Galacs/s6tm-detect-cb-2/s6tm-detect-cb-2.kicad_pcb

## KiCad design s6tm-detect-cb-2.kicad_pcb (2026-09-27)

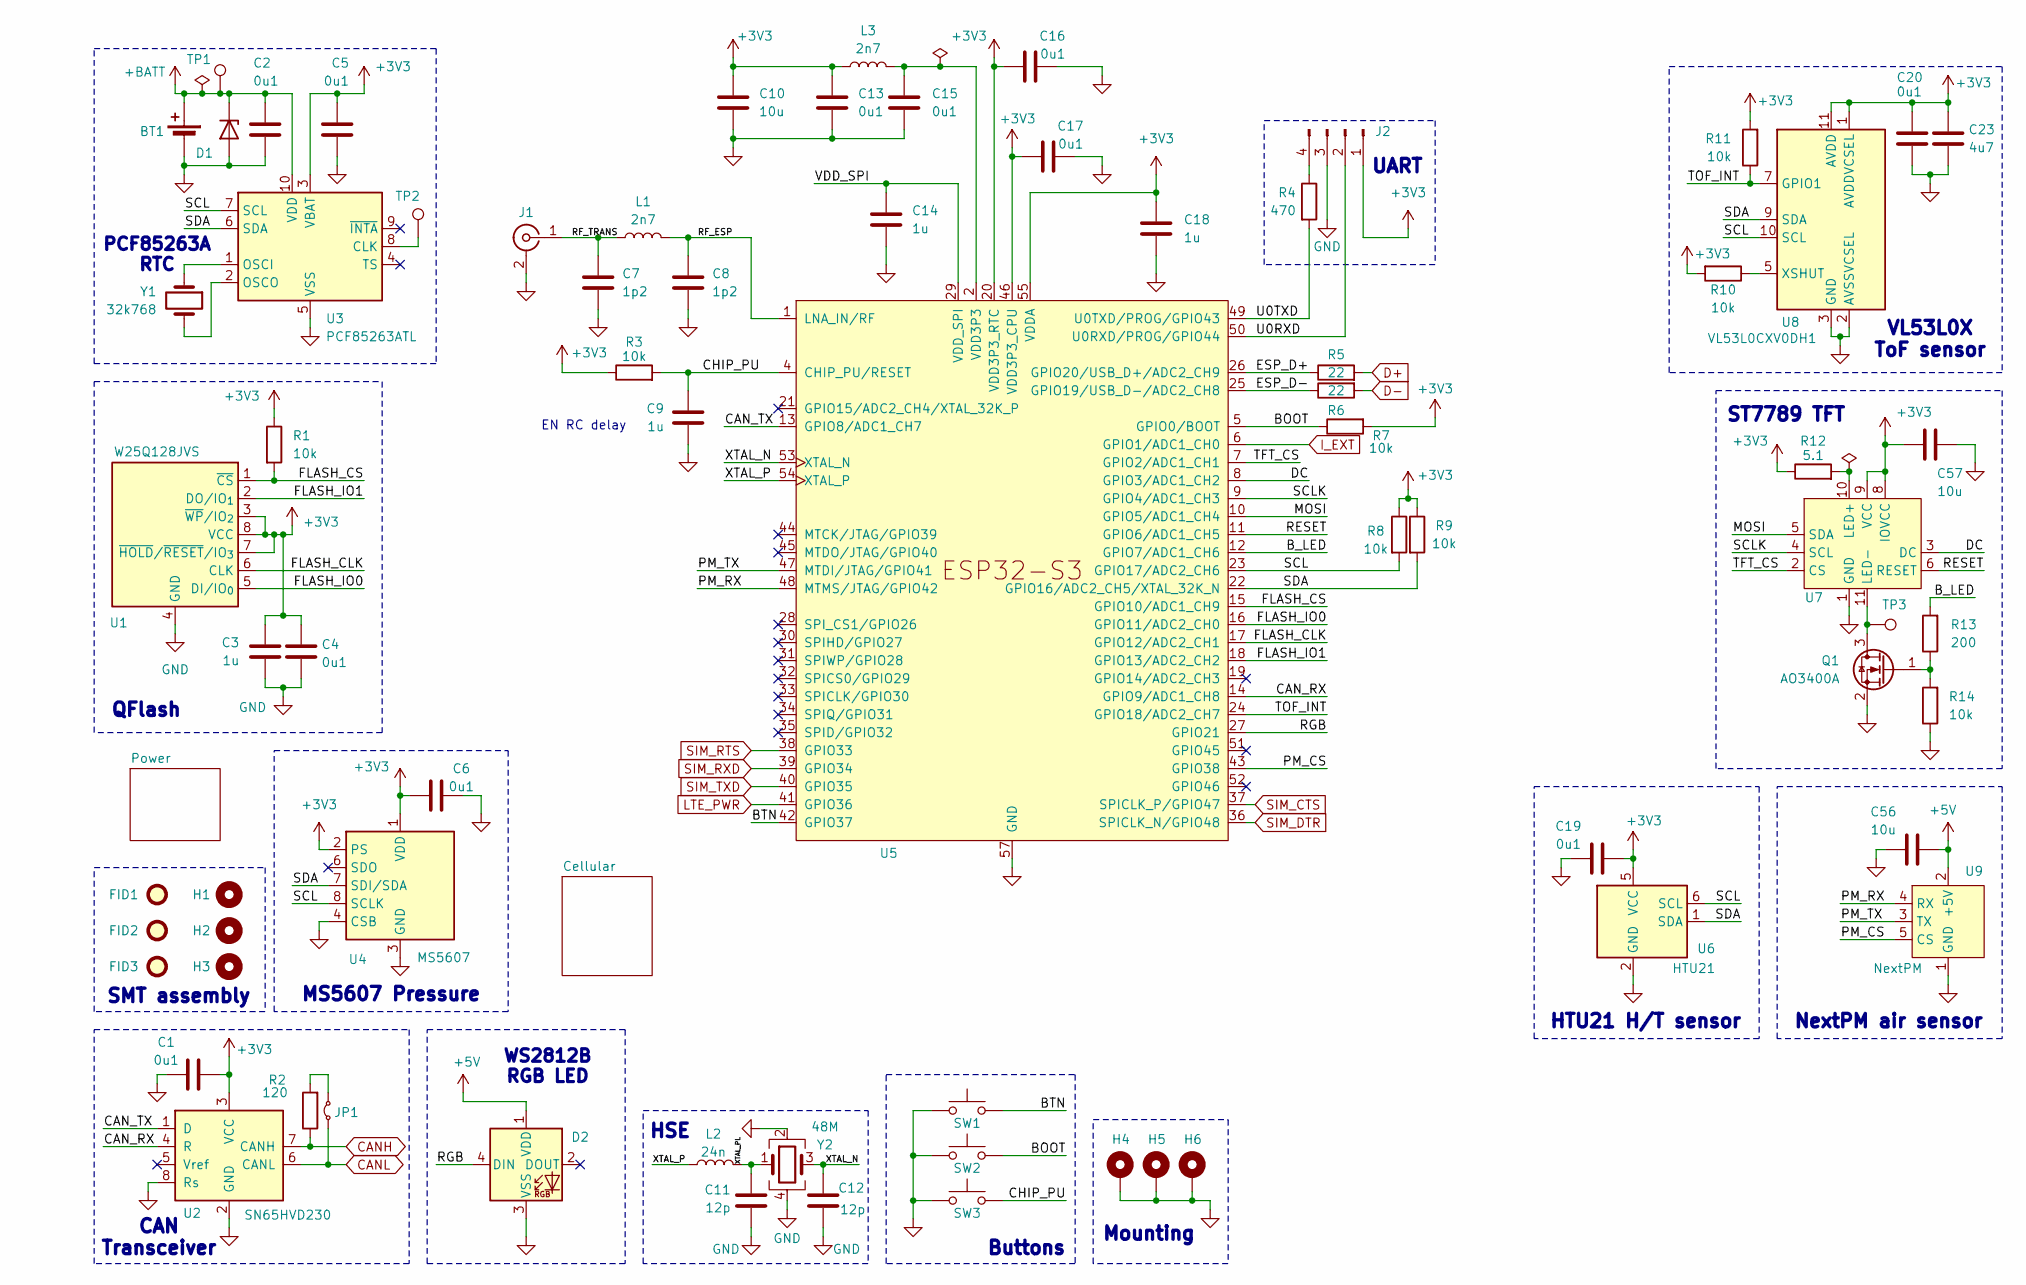
[picture p1: schematic s6tm-detect-cb-2.kicad_sch, S6TM Detect Carrier 2]

Parts:
BT1: Battery_Cell; BatteryHolder_MYOUNG_BS-08-B2AA016; Manufacturer Part Number BS-08-B2AA016; JLCPCB Part # C964792
C1, C2, C4, C5, C6, C13, C15, C16, C17, C19, C20: 0u1; C_0402_1005Metric; Manufacturer Part Number CL05B104KB54PNC; JLCPCB Part # C307331
C3, C9, C14, C18: 1u; C_0402_1005Metric; Manufacturer Part Number CL05A105KA5NQNC; JLCPCB Part # C52923
C7, C8: 1p2; C_0402_1005Metric; Manufacturer Part Number GJM1555C1H1R2WB01D; JLCPCB Part # C76899
C10, C56, C57: 10u; C_0603_1608Metric; Manufacturer Part Number CL10A106KP8NNNC; JLCPCB Part # C19702
C11, C12: 12p; C_0402_1005Metric; Manufacturer Part Number 0402CG120J500NT; JLCPCB Part # C1547
C23: 4u7; C_0402_1005Metric; Manufacturer Part Number CL05A475MP5NRNC; JLCPCB Part # C23733
D1: H5VU10U; Diode_DFN1006; Manufacturer Part Number H5VU10U; JLCPCB Part # C22395519
D2: WS2812B; LED_WS2812B_PLCC4_5.0x5.0mm_P3.2mm; Manufacturer Part Number WS2812B-V5/W; JLCPCB Part # C2874885
FID1, FID2, FID3: Fiducial; Fiducial_1mm_Mask2mm
H1, H2, H3: MountingHole; ToolingHole_1.152mm
H4, H5, H6: MountingHole_Pad; MountingHole_3.2mm_M3_Pad_Via
J1: Conn_Coaxial; U.FL_Hirose_U.FL-R-SMT-1_Vertical; Manufacturer Part Number U.FL-R-SMT-1(80); JLCPCB Part # C88374
J2: Conn_01x04_Pin; PinHeader_1x04_P2.54mm_Vertical
JP1: Jumper_2_Small_Bridged; SolderJumper-2_P1.3mm_Open_RoundedPad1.0x1.5mm
L1, L3: 2n7; L_0402_1005Metric; Manufacturer Part Number LQG15HS2N7S02D; JLCPCB Part # C77108
L2: 24n; L_0402_1005Metric; Manufacturer Part Number LQW15AN24NG00D; JLCPCB Part # C167472
Q1: AO3400A; SOT-23; Manufacturer Part Number AO3400A; JLCPCB Part # C20917
R1, R3, R7, R8, R9, R10, R11, R14: 10k; R_0402_1005Metric; Manufacturer Part Number 0402WGF1002TCE; JLCPCB Part # C25744
R2: 120; R_1206_3216Metric; Manufacturer Part Number 1206W4F1200T5E; JLCPCB Part # C17909
R4: 470; R_0402_1005Metric; Manufacturer Part Number 0402WGF4700TCE; JLCPCB Part # C25117
R5, R6: 22; R_0402_1005Metric; Manufacturer Part Number 0402WGF220JTCE; JLCPCB Part # C25092
R12: 5.1; R_0603_1608Metric; Manufacturer Part Number 0603WAF510KT5E; JLCPCB Part # C25197
R13: 200; R_0603_1608Metric; Manufacturer Part Number 0603WAF2000T5E; JLCPCB Part # C8218
SW1, SW2, SW3: SW_Push; SW_SPST_TS-1088-xR020; Manufacturer Part Number TS-1088-AR02016; JLCPCB Part # C720477
TP1, TP2, TP3: TestPoint; TestPoint_Pad_D2.0mm
U1: W25Q128JVS; SOIC-8_5.3x5.3mm_P1.27mm; Manufacturer Part Number W25Q128JVSIQ; JLCPCB Part # C97521
U2: SN65HVD230; SOIC-8_3.9x4.9mm_P1.27mm; Manufacturer Part Number SN65HVD230DR; JLCPCB Part # C12084
U3: PCF85263ATL; DFN-10-1EP_2.6x2.6mm_P0.5mm_EP1.3x2.2mm; Manufacturer Part Number PCF85263ATL/AX; JLCPCB Part # C2651523
U4: MS5607; LGA-8_3x5mm_P1.25mm; Manufacturer Part Number MS560702BA03-50; JLCPCB Part # C97627
U5: ESP32-S3FH4R2; QFN-56-1EP_7x7mm_P0.4mm_EP4x4mm_ThermalVias; Manufacturer Part Number ESP32-S3FH4R2; JLCPCB Part # C3013940
U6: HTU21; Texas_PWSON-N6; Manufacturer Part Number HTU21D; JLCPCB Part # C83479
U7: Hirose_FH12-12S-0.5SH_1x12-1MP_P0.50mm_Horizontal; Manufacturer Part Number FH12-12S-0.5SH(55); JLCPCB Part # C88360
U8: VL53L0CXV0DH1; ST_VL53L1x; Manufacturer Part Number VL53L0CXV0DH/1; JLCPCB Part # C91199
U9: NextPM; JST_PH_S6B-PH-K_1x06_P2.00mm_Horizontal; Manufacturer Part Number S6B-PH-K-S(LF)(SN); JLCPCB Part # C157920
Y1: 32k768; Crystal_SMD_3215-2Pin_3.2x1.5mm; Manufacturer Part Number C32346; JLCPCB Part # C32346
Y2: 48M; Crystal_SMD_2016-4Pin_2.0x1.6mm; Manufacturer Part Number R940000096; JLCPCB Part # C7206306

Connections:
+3V3: C1.1, C3.1, C4.1, C5.1, C6.2, C10.1, C13.1, C16.1, C17.1, C18.1, C19.2, C20.1, C23.1, C57.1, J2.1, L3.1, R1.1, R3.1, R7.2, R8.1, R9.1, R10.2, R11.2, R12.1, U1.3 (~WP/IO_{2}), U1.7 (~HOLD/~RESET/IO_{3}), U1.8 (VCC), U2.3 (VCC), U3.3 (VBAT), U4.1 (VDD), U4.2 (PS), U5.20 (VDD3P3_RTC), U5.46 (VDD3P3_CPU), U5.55 (VDDA), U5.56 (VDDA), U6.5 (VCC), U7.8 (IOVCC), U7.9 (VCC), U8.1 (AVDDVCSEL), U8.11 (AVDD); also elsewhere on the board
+5V: C56.2, D2.1 (VDD), U9.2 (+5V); also elsewhere on the board
+BATT: BT1.1 (+), C2.1, D1.1 (K), TP1.1 (1_1), U3.10 (VDD)
/BOOT: R7.1, SW2.2, U5.5 (GPIO0/BOOT)
/BTN: SW1.2, U5.42 (GPIO37)
/B_LED: R13.2, U5.12 (GPIO7/ADC1_CH6)
/CAN_RX: U2.4 (R), U5.14 (GPIO9/ADC1_CH8)
/CAN_TX: U2.1 (D), U5.13 (GPIO8/ADC1_CH7)
/CHIP_PU: C9.1, R3.2, SW3.2, U5.4 (CHIP_PU/RESET)
/DC: U5.8 (GPIO3/ADC1_CH2), U7.3 (DC)
/ESP_D+: R5.1, U5.26 (GPIO20/USB_D+/ADC2_CH9)
/ESP_D-: R6.1, U5.25 (GPIO19/USB_D-/ADC2_CH8)
/FLASH_CLK: U1.6 (CLK), U5.17 (GPIO12/ADC2_CH1)
/FLASH_CS: R1.2, U1.1 (~CS), U5.15 (GPIO10/ADC1_CH9)
/FLASH_IO0: U1.5 (DI/IO_{0}), U5.16 (GPIO11/ADC2_CH0)
/FLASH_IO1: U1.2 (DO/IO_{1}), U5.18 (GPIO13/ADC2_CH2)
/MOSI: U5.10 (GPIO5/ADC1_CH4), U7.5 (SDA)
/PM_CS: U5.43 (GPIO38), U9.5 (CS)
/PM_RX: U5.48 (MTMS/JTAG/GPIO42), U9.4 (RX)
/PM_TX: U5.47 (MTDI/JTAG/GPIO41), U9.3 (TX)
/RESET: U5.11 (GPIO6/ADC1_CH5), U7.6 (RESET)
/RF_ESP: C8.1, L1.2, U5.1 (LNA_IN/RF)
/RF_TRANS: C7.1, J1.1 (In), L1.1
/RGB: D2.4 (DIN), U5.27 (GPIO21)
/SCL: R8.2, U3.7 (SCL), U4.8 (SCLK), U5.23 (GPIO17/ADC2_CH6), U6.6 (SCL), U8.10 (SCL)
/SCLK: U5.9 (GPIO4/ADC1_CH3), U7.4 (SCL)
/SDA: R9.2, U3.6 (SDA), U4.7 (SDI/SDA), U5.22 (GPIO16/ADC2_CH5/XTAL_32K_N), U6.1 (SDA), U8.9 (SDA)
/TFT_CS: U5.7 (GPIO2/ADC1_CH1), U7.2 (CS)
/TOF_INT: R11.1, U5.24 (GPIO18/ADC2_CH7), U8.7 (GPIO1)
/U0RXD: J2.2, U5.50 (U0RXD/PROG/GPIO44)
/U0TXD: R4.2, U5.49 (U0TXD/PROG/GPIO43)
/VDD_SPI: C14.1, U5.29 (VDD_SPI)
/XTAL_N: C12.1, U5.53 (XTAL_N), Y2.3
/XTAL_P: L2.1, U5.54 (XTAL_P)
/XTAL_PL: C11.2, L2.2, Y2.1
CANH: R2.1, U2.7 (CANH); also elsewhere on the board
CANL: JP1.1 (A), U2.6 (CANL); also elsewhere on the board
D+: R5.2; also elsewhere on the board
D-: R6.2; also elsewhere on the board
EPAD: U6.7 (DAP)
GND: BT1.2 (-), C1.2, C2.2, C3.2, C4.2, C5.2, C6.1, C7.2, C8.2, C9.2, C10.2, C11.1, C12.2, C13.2, C14.2, C15.2, C16.2, C17.2, C18.2, C19.1, C20.2, C23.2, C56.1, C57.2, D1.2 (A), D2.3 (VSS), H4.1 (1_1), H5.1 (1_1), H6.1 (1_1), J1.2 (Ext), J2.3, Q1.2 (S), R14.1, SW1.1, SW2.1, SW3.1, U1.4 (GND), U2.2 (GND), U2.8 (Rs), U3.5 (VSS), U4.3 (GND), U4.4 (CSB), U4.5 (CSB), U5.57 (GND), U6.2 (GND), U7.1 (GND), U7.12 (GND), U7.MP (GND), U8.2 (AVSSVCSEL), U8.3 (GND), U8.4 (GND), U8.6 (GND), U8.12 (GND), U9.1 (GND), U9.6 (GND), Y2.2, Y2.4; also elsewhere on the board
I_EXT: U5.6 (GPIO1/ADC1_CH0); also elsewhere on the board
LTE_PWR: U5.41 (GPIO36); also elsewhere on the board
unnamed: J2.4, R4.1
unnamed: JP1.2 (B), R2.2
unnamed: Q1.3 (D), TP3.1 (1_1), U7.11 (LED-)
unnamed: Q1.1 (G), R13.1, R14.2
unnamed: TP2.1 (1_1), U3.8 (CLK)
unnamed: U3.1 (OSCI), Y1.1
unnamed: U3.2 (OSCO), Y1.2
unnamed: R12.2, U7.10 (LED+)
unnamed: R10.1, U8.5 (XSHUT)
SIM_CTS: U5.37 (SPICLK_P/GPIO47); also elsewhere on the board
SIM_DTR: U5.36 (SPICLK_N/GPIO48); also elsewhere on the board
SIM_RTS: U5.38 (GPIO33); also elsewhere on the board
SIM_RXD: U5.39 (GPIO34); also elsewhere on the board
SIM_TXD: U5.40 (GPIO35); also elsewhere on the board
VDD3P3: C15.1, L3.2, U5.2 (VDD3P3), U5.3 (VDD3P3)

Notes on the sheet:
WS2812B RGB LED
NextPM air sensor
ST7789 TFT
HTU21 H/T sensor
HSE
CAN Transceiver
QFlash
VL53L0X ToF sensor
PCF85263A RTC
SMT assembly
MS5607 Pressure
EN RC delay
UART
Mounting
Buttons

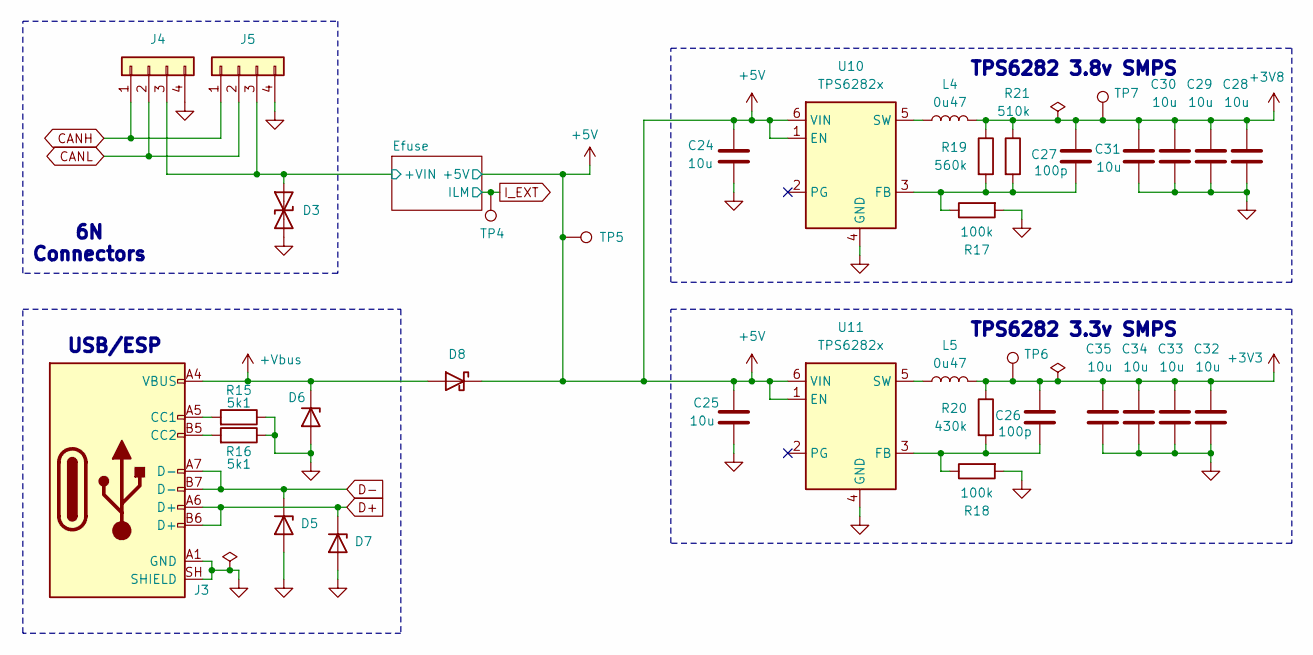
[picture p2: schematic power.kicad_sch, S6TM Detect Carrier 2]

Parts:
C24, C25, C28, C29, C30, C31, C32, C33, C34, C35: 10u; C_0603_1608Metric; Manufacturer Part Number CL10A106KP8NNNC; JLCPCB Part # C19702
C26, C27: 100p; C_0402_1005Metric; Manufacturer Part Number 0402CG101J500NT; JLCPCB Part # C1546
D3: SMBJ6.0CA; D_SMB; Manufacturer Part Number SMBJ6.0CA; JLCPCB Part # C2925451
D5, D6, D7: H5VU10U; Diode_DFN1006; Manufacturer Part Number H5VU10U; JLCPCB Part # C22395519
D8: D_Schottky; D_SMA; Manufacturer Part Number SS54; JLCPCB Part # C22452
J3: USB_C_Receptacle_USB2.0_14P; USB_C_Receptacle_HRO_TYPE-C-31-M-12; Manufacturer Part Number TYPE-C16PIN; JLCPCB Part # C393939
J4, J5: Conn_01x04; JST_XH_S4B-XH-A-1_1x04_P2.50mm_Horizontal; Manufacturer Part Number S4B-XH-A-1(LF)(SN); JLCPCB Part # C163037
L4, L5: 0u47; TDK_TFM201610ALC; Manufacturer Part Number TFM201610GHM-R47MTAA; JLCPCB Part # C89446
R15, R16: 5k1; R_0402_1005Metric; Manufacturer Part Number 0402WGF5101TCE; JLCPCB Part # C25905
R17, R18: 100k; R_0402_1005Metric; Manufacturer Part Number 0402WGF1003TCE; JLCPCB Part # C25741
R19: 560k; R_0603_1608Metric; Manufacturer Part Number 0603WAF5603T5E; JLCPCB Part # C23203
R20: 430k; R_0603_1608Metric; Manufacturer Part Number 0603WAF4303T5E; JLCPCB Part # C25969
R21: 510k; R_0603_1608Metric; Manufacturer Part Number 0603WAF5103T5E; JLCPCB Part # C23192
TP4, TP5, TP6, TP7: TestPoint; TestPoint_Pad_D2.0mm
U10, U11: TPS6282x; Texas_VSON-6_1.5x1.5mm_P0.5mm_DMQ0006A; Manufacturer Part Number TPS62825DMQR; JLCPCB Part # C2650334

Connections:
+3V3: C26.1, C32.1, C33.1, C34.1, C35.1, L5.2, R20.1, TP6.1 (1_1); also elsewhere on the board
+3V8: C27.1, C28.1, C29.1, C30.1, C31.1, L4.2, R19.1, R21.1, TP7.1 (1_1); also elsewhere on the board
+5V: C24.1, C25.1, D8.1 (K), TP5.1 (1_1), U10.1 (EN), U10.6 (VIN), U11.1 (EN), U11.6 (VIN); also elsewhere on the board
+Vbus: D6.1 (K), D8.2 (A), J3.A4 (VBUS), J3.A9 (VBUS), J3.B4 (VBUS), J3.B9 (VBUS)
/Power/Efuse/+VIN: D3.1 (A1), J4.3, J5.3; also elsewhere on the board
CANH: J4.1, J5.1; also elsewhere on the board
CANL: J4.2, J5.2; also elsewhere on the board
D+: D7.1 (K), J3.A6 (D+), J3.B6 (D+); also elsewhere on the board
D-: D5.1 (K), J3.A7 (D-), J3.B7 (D-); also elsewhere on the board
GND: C24.2, C25.2, C28.2, C29.2, C30.2, C31.2, C32.2, C33.2, C34.2, C35.2, D3.2 (A2), D5.2 (A), D6.2 (A), D7.2 (A), J3.A1 (GND), J3.A12 (GND), J3.B1 (GND), J3.B12 (GND), J3.SH (SHIELD), J4.4, J5.4, R15.1, R16.1, R17.2, R18.2, U10.4 (GND), U11.4 (GND); also elsewhere on the board
I_EXT: TP4.1 (1_1); also elsewhere on the board
unnamed: J3.A5 (CC1), R15.2
unnamed: J3.B5 (CC2), R16.2
unnamed: C27.2, R17.1, R19.2, R21.2, U10.3 (FB)
unnamed: L4.1, U10.5 (SW)
unnamed: C26.2, R18.1, R20.2, U11.3 (FB)
unnamed: L5.1, U11.5 (SW)

Notes on the sheet:
TPS6282 3.3v SMPS
TPS6282 3.8v SMPS
6N Connectors
USB/ESP

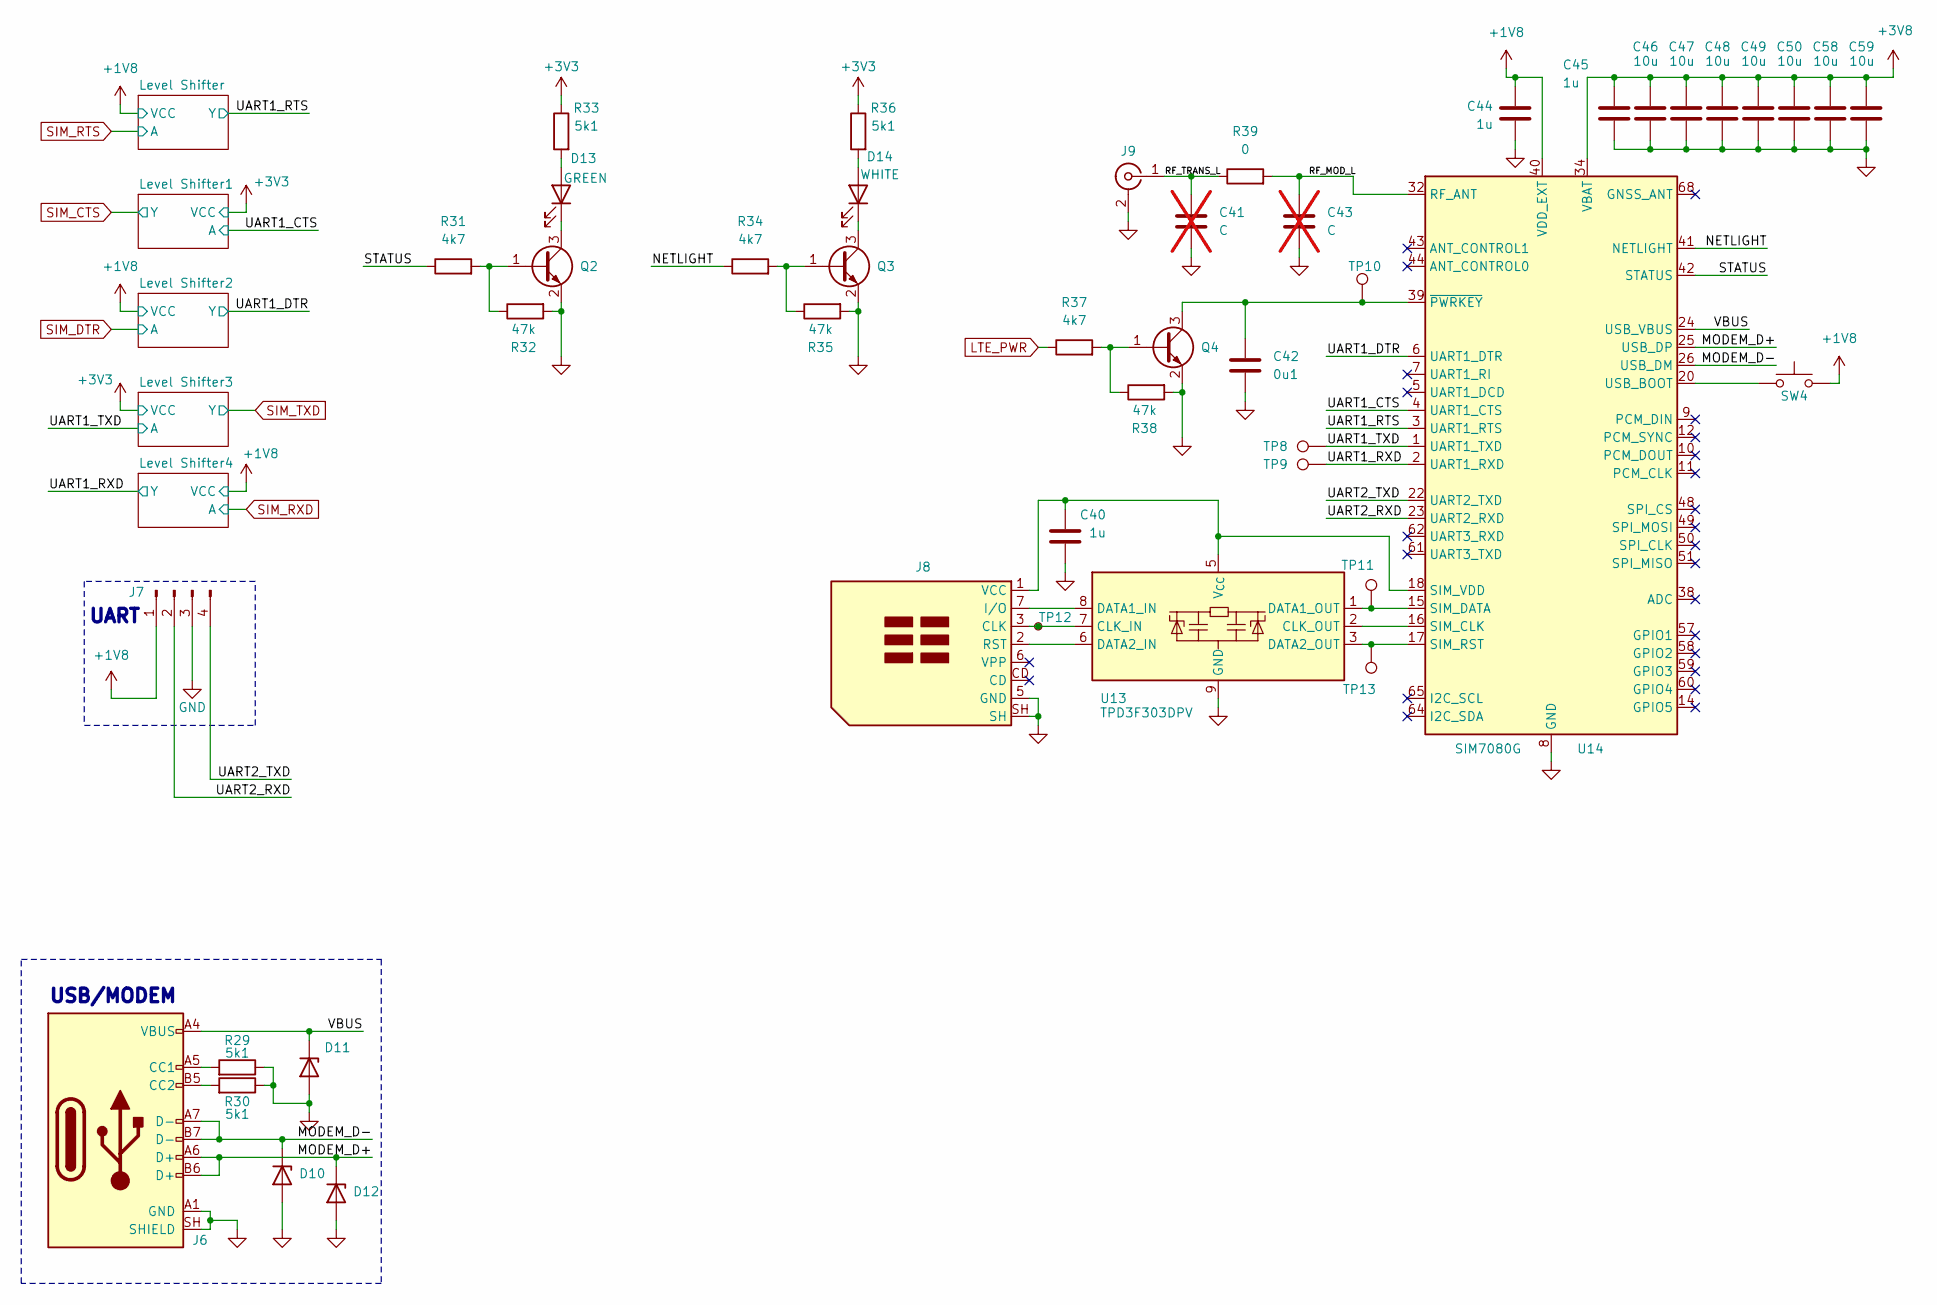
[picture p3: schematic cellular.kicad_sch, S6TM Detect Carrier 2]

Parts:
C40, C44, C45: 1u; C_0402_1005Metric; Manufacturer Part Number CL05A105KA5NQNC; JLCPCB Part # C52923
C41, C43: C; C_0402_1005Metric; not fitted
C42: 0u1; C_0402_1005Metric; Manufacturer Part Number CL05B104KB54PNC; JLCPCB Part # C307331
C46, C47, C48, C49, C50, C58, C59: 10u; C_0603_1608Metric; Manufacturer Part Number CL10A106KP8NNNC; JLCPCB Part # C19702
D10, D11, D12: H5VU10U; Diode_DFN1006; Manufacturer Part Number H5VU10U; JLCPCB Part # C22395519
D13: GREEN; LED_0805_2012Metric; Manufacturer Part Number KT-0805G; JLCPCB Part # C2297
D14: WHITE; LED_0603_1608Metric; Manufacturer Part Number KT-0603W; JLCPCB Part # C2290
J6: USB_C_Receptacle_USB2.0_14P; USB_C_Receptacle_HRO_TYPE-C-31-M-12; Manufacturer Part Number TYPE-C16PIN; JLCPCB Part # C393939
J7: Conn_01x04_Pin; PinHeader_1x04_P2.54mm_Vertical
J8: SIM_Card_Shielded; nanoSIM_Hinged_CUI_NSIM-2-C; Manufacturer Part Number SMN-305-ARP7; JLCPCB Part # C720512
J9: Conn_Coaxial; U.FL_Hirose_U.FL-R-SMT-1_Vertical; Manufacturer Part Number U.FL-R-SMT-1(80); JLCPCB Part # C88374
Q2, Q3, Q4: MMBT3904; SOT-23; Manufacturer Part Number MMBT3904(RANGE:100-300); JLCPCB Part # C20526
R29, R30, R33, R36: 5k1; R_0402_1005Metric; Manufacturer Part Number 0402WGF5101TCE; JLCPCB Part # C25905
R31, R34, R37: 4k7; R_0402_1005Metric; Manufacturer Part Number 0402WGF4701TCE; JLCPCB Part # C25900
R32, R35, R38: 47k; R_0402_1005Metric; Manufacturer Part Number 0402WGF4702TCE; JLCPCB Part # C25792
R39: 0; R_0402_1005Metric; Manufacturer Part Number 0402WGF0000TCE; JLCPCB Part # C17168
SW4: SW_Push; SW_SPST_TS-1088-xR020; Manufacturer Part Number TS-1088-AR02016; JLCPCB Part # C720477
TP8, TP9, TP10, TP11, TP12, TP13: TestPoint; TestPoint_Pad_D2.0mm
U13: TPD3F303DPV; Texas_R-PUSON-N8_USON-8-1EP_1.6x2.1mm_P0.5mm_EP0.4x1.7mm; Manufacturer Part Number TPD3F303DPVR; JLCPCB Part # C2865991
U14: SIM7080G; SIMCom_SIM7080G; Manufacturer Part Number C2943992; JLCPCB Part # C2943992

Connections:
+1V8: C44.2, J7.1, SW4.2, U14.40 (VDD_EXT); also elsewhere on the board
+3V3: R33.1, R36.1; also elsewhere on the board
+3V8: C45.2, C46.1, C47.1, C48.1, C49.1, C50.1, C58.1, C59.1, U14.34 (VBAT), U14.35 (VBAT); also elsewhere on the board
/Cellular/MODEM_D+: D12.1 (K), J6.A6 (D+), J6.B6 (D+), U14.25 (USB_DP)
/Cellular/MODEM_D-: D10.1 (K), J6.A7 (D-), J6.B7 (D-), U14.26 (USB_DM)
/Cellular/NETLIGHT: R34.1, U14.41 (NETLIGHT)
/Cellular/RF_MOD_L: C43.1, R39.2, U14.32 (RF_ANT)
/Cellular/RF_TRANS_L: C41.1, J9.1 (In), R39.1
/Cellular/STATUS: R31.1, U14.42 (STATUS)
/Cellular/UART1_CTS: U14.4 (UART1_CTS); also elsewhere on the board
/Cellular/UART1_DTR: U14.6 (UART1_DTR); also elsewhere on the board
/Cellular/UART1_RTS: U14.3 (UART1_RTS); also elsewhere on the board
/Cellular/UART1_RXD: TP9.1 (1_1), U14.2 (UART1_RXD); also elsewhere on the board
/Cellular/UART1_TXD: TP8.1 (1_1), U14.1 (UART1_TXD); also elsewhere on the board
/Cellular/UART2_RXD: J7.2, U14.23 (UART2_RXD)
/Cellular/UART2_TXD: J7.4, U14.22 (UART2_TXD)
/Cellular/VBUS: D11.1 (K), J6.A4 (VBUS), J6.A9 (VBUS), J6.B4 (VBUS), J6.B9 (VBUS), U14.24 (USB_VBUS)
GND: C40.1, C41.2, C42.1, C43.2, C44.1, C45.1, C46.2, C47.2, C48.2, C49.2, C50.2, C58.2, C59.2, D10.2 (A), D11.2 (A), D12.2 (A), J6.A1 (GND), J6.A12 (GND), J6.B1 (GND), J6.B12 (GND), J6.SH (SHIELD), J7.3, J8.5 (GND), J8.SH, J9.2 (Ext), Q2.2 (E), Q3.2 (E), Q4.2 (E), R29.1, R30.1, R32.2, R35.2, R38.2, U13.9 (GND), U14.8 (GND), U14.13 (GND), U14.19 (GND), U14.21 (GND), U14.27 (GND), U14.30 (GND), U14.31 (GND), U14.33 (GND), U14.36 (GND), U14.37 (GND), U14.45 (GND), U14.63 (GND), U14.66 (GND), U14.67 (GND), U14.69 (GND), U14.70 (GND), U14.71 (GND), U14.72 (GND), U14.73 (GND), U14.74 (GND), U14.75 (GND), U14.76 (GND), U14.77 (GND); also elsewhere on the board
LTE_PWR: R37.1; also elsewhere on the board
unnamed: D13.2 (A), R33.2
unnamed: D13.1 (K), Q2.3 (C)
unnamed: D14.2 (A), R36.2
unnamed: D14.1 (K), Q3.3 (C)
unnamed: J6.A5 (CC1), R29.2
unnamed: J6.B5 (CC2), R30.2
unnamed: J8.3 (CLK), TP12.1 (1_1), U13.7 (CLK_IN)
unnamed: J8.7 (I/O), U13.8 (DATA1_IN)
unnamed: J8.2 (RST), U13.6 (DATA2_IN)
unnamed: C40.2, J8.1 (VCC), U13.5 (V_{CC}), U14.18 (SIM_VDD)
unnamed: Q2.1 (B), R31.2, R32.1
unnamed: Q3.1 (B), R34.2, R35.1
unnamed: Q4.1 (B), R37.2, R38.1
unnamed: C42.2, Q4.3 (C), TP10.1 (1_1), U14.39 (~PWRKEY)
unnamed: U13.2 (CLK_OUT), U14.16 (SIM_CLK)
unnamed: TP11.1 (1_1), U13.1 (DATA1_OUT), U14.15 (SIM_DATA)
unnamed: TP13.1 (1_1), U13.3 (DATA2_OUT), U14.17 (SIM_RST)
unnamed: SW4.1, U14.20 (USB_BOOT)

Notes on the sheet:
UART
USB/MODEM

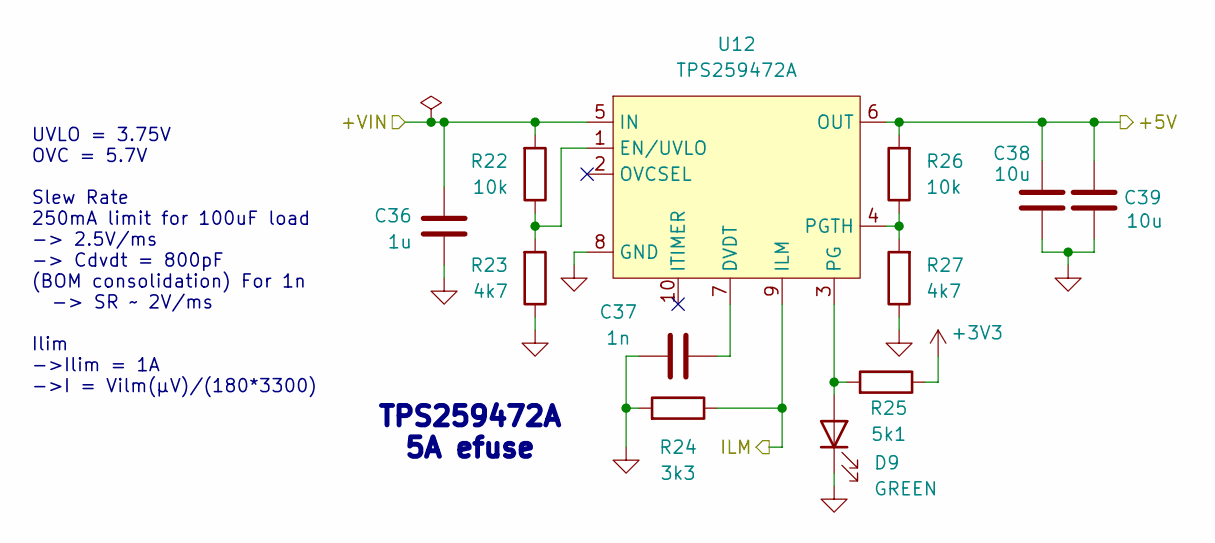
[picture p4: schematic efuse.kicad_sch, S6TM Detect Carrier 2]

Parts:
C36: 1u; C_0402_1005Metric; Manufacturer Part Number CL05A105KA5NQNC; JLCPCB Part # C52923
C37: 1n; C_0402_1005Metric; Manufacturer Part Number 0402B102K500NT; JLCPCB Part # C1523
C38, C39: 10u; C_0603_1608Metric; Manufacturer Part Number CL10A106KP8NNNC; JLCPCB Part # C19702
D9: GREEN; LED_0805_2012Metric; Manufacturer Part Number KT-0805G; JLCPCB Part # C2297
R22, R26: 10k; R_0402_1005Metric; Manufacturer Part Number 0402WGF1002TCE; JLCPCB Part # C25744
R23, R27: 4k7; R_0402_1005Metric; Manufacturer Part Number 0402WGF4701TCE; JLCPCB Part # C25900
R24: 3k3; R_0402_1005Metric; Manufacturer Part Number 0402WGF3301TCE; JLCPCB Part # C25890
R25: 5k1; R_0402_1005Metric; Manufacturer Part Number 0402WGF5101TCE; JLCPCB Part # C25905
U12: TPS259472A; Texas_RPW0010A_VQFN-HR-10_2x2mm_P0.5mm; Manufacturer Part Number TPS259472ARPWR; JLCPCB Part # C3662789

Connections:
+3V3: R25.1; also elsewhere on the board
+5V: C38.1, C39.1, R26.2, U12.6 (OUT); also elsewhere on the board
/Power/Efuse/+VIN: C36.2, R22.2, U12.5 (IN); also elsewhere on the board
GND: C36.1, C37.2, C38.2, C39.2, D9.1 (K), R23.1, R24.2, R27.1, U12.8 (GND); also elsewhere on the board
I_EXT: R24.1, U12.9 (ILM); also elsewhere on the board
unnamed: D9.2 (A), R25.2, U12.3 (PG)
unnamed: C37.1, U12.7 (DVDT)
unnamed: R22.1, R23.2, U12.1 (EN/UVLO)
unnamed: R26.1, R27.2, U12.4 (PGTH)

Notes on the sheet:
TPS259472A 5A efuse
UVLO = 3.75V OVC = 5.7V Slew Rate 250mA limit for 100uF load -> 2.5V/ms -> Cdvdt = 800pF (BOM consolidation) For 1n -> SR ~ 2V/ms Ilim ->Ilim = 1A ->I = Vilm(µV)/(180*3300)

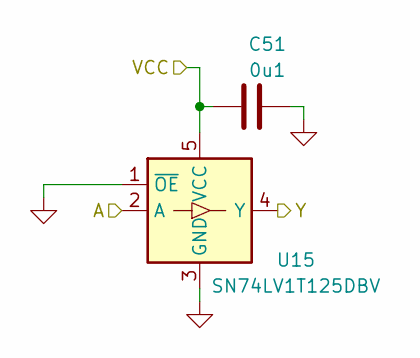
[picture p5: schematic level-shifter.kicad_sch, S6TM Detect Carrier 2]

Parts:
C51: 0u1; C_0402_1005Metric; Manufacturer Part Number CL05B104KB54PNC; JLCPCB Part # C307331
U15: SN74LV1T125DBV; SOT-23-5; Manufacturer Part Number SN74LV1T125DBVR; JLCPCB Part # C473338

Connections:
+1V8: C51.1, U15.5 (VCC); also elsewhere on the board
/Cellular/UART1_RTS: U15.4 (Y); also elsewhere on the board
GND: C51.2, U15.1 (~OE), U15.3 (GND); also elsewhere on the board
SIM_RTS: U15.2 (A); also elsewhere on the board

Parts of its further copies:
C52, C53, C54, C55: 0u1; C_0402_1005Metric; Manufacturer Part Number CL05B104KB54PNC; JLCPCB Part # C307331
U16, U17, U18, U19: SN74LV1T125DBV; SOT-23-5; Manufacturer Part Number SN74LV1T125DBVR; JLCPCB Part # C473338

Connections of its further copies:
+1V8: C53.1, C55.1, U17.5 (VCC), U19.5 (VCC); also elsewhere on the board
+3V3: C52.1, C54.1, U16.5 (VCC), U18.5 (VCC); also elsewhere on the board
/Cellular/UART1_CTS: U16.2 (A); also elsewhere on the board
/Cellular/UART1_DTR: U17.4 (Y); also elsewhere on the board
/Cellular/UART1_RXD: U19.4 (Y); also elsewhere on the board
/Cellular/UART1_TXD: U18.2 (A); also elsewhere on the board
GND: C52.2, C53.2, C54.2, C55.2, U16.1 (~OE), U16.3 (GND), U17.1 (~OE), U17.3 (GND), U18.1 (~OE), U18.3 (GND), U19.1 (~OE), U19.3 (GND); also elsewhere on the board
SIM_CTS: U16.4 (Y); also elsewhere on the board
SIM_DTR: U17.2 (A); also elsewhere on the board
SIM_RXD: U19.2 (A); also elsewhere on the board
SIM_TXD: U18.4 (Y); also elsewhere on the board

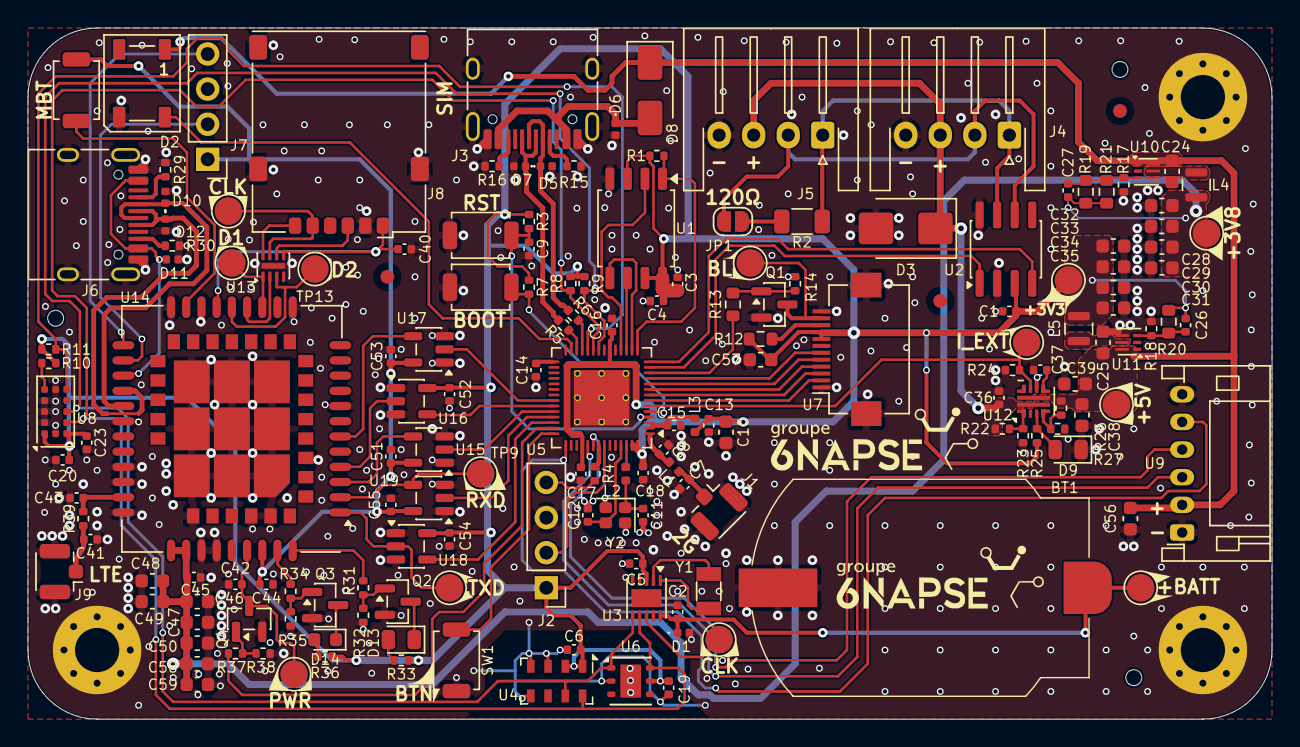
[picture p6: board s6tm-detect-cb-2.kicad_pcb from above]

Board: 4 copper layers, 90.0 x 50.0 mm, 175 parts (0 on the bottom side), 103 nets.
