Galacs/s6tm-detect-cb-2/(commit log)

2026-09-13 schem: add esp32-s3
    [s6tm-detect-cb-2.kicad_sch]
2026-09-13 schem: add hse crystal
    [s6tm-detect-cb-2.kicad_sch]
2026-09-13 schem: add usb-c connector
    [s6tm-detect-cb-2.kicad_sch]
2026-09-13 schem: add can transceiver
    [s6tm-detect-cb-2.kicad_sch]
2026-09-13 schem: add buttons
    [s6tm-detect-cb-2.kicad_sch]
2026-09-13 schem: add WS2812B RGB LED
    [s6tm-detect-cb-2.kicad_sch]
2026-09-13 schem: add nextpm 6pin connector
    [s6tm-detect-cb-2.kicad_sch]
2026-09-13 schem: add smt assembly fids and tooling holes
    [s6tm-detect-cb-2.kicad_sch]
2026-09-13 schem: add m3 mounting holes
    [s6tm-detect-cb-2.kicad_sch]
2026-09-13 schem: switch to external rf antenna
    [s6tm-detect-cb-2.kicad_sch]
2026-09-13 schem: add htu21 h/t sensor
    [s6tm-detect-cb-2.kicad_sch]
2026-09-13 schem: add MAX40203 ideal diode
    [s6tm-detect-cb-2.kicad_sch]
2026-09-13 schem: add TPS6282 3.3v SMPS
    [s6tm-detect-cb-2.kicad_sch]
2026-09-13 schem: update smps L part number
    [s6tm-detect-cb-2.kicad_sch]
2026-09-13 schem: add ST7789 TFT connector
    [s6tm-detect-cb-2.kicad_sch]
2026-09-13 schem: add tft dimming circuit
    [s6tm-detect-cb-2.kicad_sch]
2026-09-13 schem: add MS5607 Pressure sensor
    [s6tm-detect-cb-2.kicad_sch]
2026-09-13 schem: add second CAN connector
    [s6tm-detect-cb-2.kicad_sch]
2026-09-13 schem: add efuse orings
    [efuse.kicad_sch, power.kicad_sch, s6tm-detect-cb-2.kicad_sch]
2026-09-13 schem: reorganize
    [power.kicad_sch, s6tm-detect-cb-2.kicad_sch]
2026-09-13 schem: add 128 Mbits spi flash
    [s6tm-detect-cb-2.kicad_sch]
2026-09-13 schem: add PCF85263A RTC
    [efuse.kicad_sch, power.kicad_sch, s6tm-detect-cb-2.kicad_sch]
2026-09-13 schem: add battery holder footprint
    [s6tm-detect-cb-2.kicad_sch]
2026-09-13 schem: update cr2032 part #
    [s6tm-detect-cb-2.kicad_sch]
2026-09-13 schem: add RTC to BOM
    [s6tm-detect-cb-2.kicad_sch]
2026-09-14 schem: update +5v tvs diode part #
    [power.kicad_sch]
2026-09-15 schem: add VL53L0X ToF sensor
    [s6tm-detect-cb-2.kicad_sch]
2026-09-15 schem: connect peripherals to mcu
    [s6tm-detect-cb-2.kicad_sch]
2026-09-15 schem: add test points
    [power.kicad_sch, s6tm-detect-cb-2.kicad_sch]
2026-09-15 schem: add no connects
    [s6tm-detect-cb-2.kicad_sch]
2026-09-20 schem: replace vbus efuse with diode
    [efuse.kicad_sch, power.kicad_sch]
2026-09-20 schem: add +3v3 bulk decoupling caps
    [power.kicad_sch]
2026-09-21 schem: add +3v8 smps
    [cellular.kicad_sch, power.kicad_sch, s6tm-detect-cb-2.kicad_sch]
2026-09-21 schem: add sim7080G lte module
    [cellular.kicad_sch]
2026-09-21 schem: add lte decoupling caps
    [cellular.kicad_sch]
2026-09-21 schem: add lte pwr control
    [cellular.kicad_sch]
2026-09-21 schem: add level shifter
    [cellular.kicad_sch, level-shifter.kicad_sch]
2026-09-22 schem: add sim uart level shifters
    [cellular.kicad_sch, level-shifter.kicad_sch]
2026-09-22 schem: add status and netlight
    [cellular.kicad_sch]
2026-09-22 schem: add modem usb connector
    [cellular.kicad_sch]
2026-09-22 schem: add modem no connects
    [cellular.kicad_sch]
2026-09-22 schem: add modem uart port
    [cellular.kicad_sch]
2026-09-22 schem: add modem uart test points
    [cellular.kicad_sch]
2026-09-23 schem: add modem sim card
    [cellular.kicad_sch]
2026-09-24 schem: connect modem to uart
    [cellular.kicad_sch, s6tm-detect-cb-2.kicad_sch]
2026-09-24 schem: update rf antenna part
    [s6tm-detect-cb-2.kicad_sch]
2026-09-24 schem: add modem lte rf ant
    [cellular.kicad_sch]
2026-09-24 schem: run and fix ERC
    [cellular.kicad_sch, power.kicad_sch, s6tm-detect-cb-2.kicad_sch]
2026-09-24 schem: add test point
    [s6tm-detect-cb-2.kicad_sch]
2026-09-24 schem: add net classes
    [cellular.kicad_sch]
2026-09-24 schem: add footprints
    [cellular.kicad_sch]
2026-09-24 schem: add ordering info to BOM
    [cellular.kicad_sch, s6tm-detect-cb-2.kicad_sch]
2026-09-24 schem: add sheet titles
    [cellular.kicad_sch, efuse.kicad_sch, level-shifter.kicad_sch, power.kicad_sch, s6tm-detect-cb-2.kicad_sch]
2026-09-24 schem: reannotate
    [cellular.kicad_sch, efuse.kicad_sch, level-shifter.kicad_sch, power.kicad_sch, s6tm-detect-cb-2.kicad_sch]
2026-09-24 pcb: import jlc 4 layer stackup
    [s6tm-detect-cb-2.kicad_pcb]
2026-09-24 schem: update footprints to glcs
    [power.kicad_sch]
2026-09-24 schem: fix footprints
    [cellular.kicad_sch]
2026-09-24 pcb: import footprints from schem
    [s6tm-detect-cb-2.kicad_pcb]
2026-09-24 pcb: add missing 3d models
    [s6tm-detect-cb-2.kicad_pcb]
2026-09-25 schem: update gnd net class priority
    [cellular.kicad_sch, s6tm-detect-cb-2.kicad_pcb]
2026-09-25 pcb: initial sectionning
    [s6tm-detect-cb-2.kicad_pcb]
2026-09-26 pcb: add usb c layout
    [s6tm-detect-cb-2.kicad_pcb]
2026-09-26 pcb: add flash layout
    [s6tm-detect-cb-2.kicad_pcb]
2026-09-26 pcb: add rtc layout
    [s6tm-detect-cb-2.kicad_pcb]
2026-09-26 pcb: add esp32 layout
    [s6tm-detect-cb-2.kicad_pcb]
2026-09-26 schem: update esp32 footprint
    [s6tm-detect-cb-2.kicad_sch]
2026-09-26 schem: fix can net labels
    [power.kicad_sch, s6tm-detect-cb-2.kicad_sch]
2026-09-26 pcb: route can connectors
    [s6tm-detect-cb-2.kicad_pcb]
2026-09-26 pcb: add +5v efuse layout
    [s6tm-detect-cb-2.kicad_pcb]
2026-09-26 schem: update 10u caps to 0603
    [cellular.kicad_sch, efuse.kicad_sch, power.kicad_sch, s6tm-detect-cb-2.kicad_sch]
2026-09-26 pcb: add SMPSs layout
    [power.kicad_sch, s6tm-detect-cb-2.kicad_pcb]
2026-09-26 pcb: add laser & tft layout
    [power.kicad_sch, s6tm-detect-cb-2.kicad_pcb, s6tm-detect-cb-2.kicad_sch]
2026-09-26 pcb: add sim layout
    [cellular.kicad_sch, s6tm-detect-cb-2.kicad_pcb]
2026-09-26 pcb: add level shifters layout
    [s6tm-detect-cb-2.kicad_pcb]
2026-09-26 pcb: add placement
    [cellular.kicad_sch, s6tm-detect-cb-2.kicad_pcb]
2026-09-27 pcb: add gnd planes
    [s6tm-detect-cb-2.kicad_pcb]
2026-09-27 pcb: add gnd vias
    [s6tm-detect-cb-2.kicad_pcb]
2026-09-27 pcb: add drill/place origin
    [s6tm-detect-cb-2.kicad_pcb]
2026-09-27 schem: reorganize programmable gpios
    [s6tm-detect-cb-2.kicad_pcb, s6tm-detect-cb-2.kicad_sch]
2026-09-27 pcb: route rf
    [s6tm-detect-cb-2.kicad_pcb]
2026-09-27 pcb: route xtals
    [s6tm-detect-cb-2.kicad_pcb]
2026-09-27 pcb: route usbs
    [s6tm-detect-cb-2.kicad_pcb]
2026-09-27 pcb: switch to 0.2mm traces
    [s6tm-detect-cb-2.kicad_pcb]
2026-09-27 pcb: route spi flash
    [s6tm-detect-cb-2.kicad_pcb]
2026-09-27 pcb: route can
    [s6tm-detect-cb-2.kicad_pcb, s6tm-detect-cb-2.kicad_sch]
2026-09-27 pcb: route uarts
    [s6tm-detect-cb-2.kicad_pcb, s6tm-detect-cb-2.kicad_sch]
2026-09-27 pcb: route tft spi display
    [s6tm-detect-cb-2.kicad_pcb]
2026-09-27 pcb: route smpss
    [s6tm-detect-cb-2.kicad_pcb]
2026-09-27 pcb: route sim
    [s6tm-detect-cb-2.kicad_pcb]
2026-09-27 pcb: route i2c
    [s6tm-detect-cb-2.kicad_pcb]
2026-09-27 pcb: route efuse
    [s6tm-detect-cb-2.kicad_pcb]
2026-09-27 pcb: route pm cs
    [s6tm-detect-cb-2.kicad_pcb]
2026-09-27 pcb: route modem
    [s6tm-detect-cb-2.kicad_pcb]
2026-09-27 pcb: route temperature sensors
    [s6tm-detect-cb-2.kicad_pcb]
2026-09-27 pcb: route rgb
    [s6tm-detect-cb-2.kicad_pcb]
2026-09-27 pcb: route tof
    [s6tm-detect-cb-2.kicad_pcb]
2026-09-27 pcb: route boot/rst buttons
    [s6tm-detect-cb-2.kicad_pcb]
2026-09-27 pcb: add +3v3 pwr routing
    [s6tm-detect-cb-2.kicad_pcb]
2026-09-27 pcb: route +vbus
    [s6tm-detect-cb-2.kicad_pcb]
2026-09-27 pcb: route +5v
    [s6tm-detect-cb-2.kicad_pcb]
2026-09-27 pcb: route +batt
    [s6tm-detect-cb-2.kicad_pcb]
2026-09-27 pcb: route +1v8
    [s6tm-detect-cb-2.kicad_pcb]
2026-09-27 schem: add 2 bulk cap to modem +3v8
    [cellular.kicad_sch]
2026-09-27 pcb: route +3v8
    [s6tm-detect-cb-2.kicad_pcb]
2026-09-27 pcb: add missing connection
    [s6tm-detect-cb-2.kicad_pcb]
2026-09-27 pcb: add stitching vias
    [s6tm-detect-cb-2.kicad_pcb]
2026-09-27 pcb: run and fix DRC
    [s6tm-detect-cb-2.kicad_pcb]
2026-09-27 pcb: remove unused internal pads
    [s6tm-detect-cb-2.kicad_pcb]
2026-09-27 pcb(silk): clean reference designators
    [s6tm-detect-cb-2.kicad_pcb]
2026-09-27 pcb: add title
    [s6tm-detect-cb-2.kicad_pcb]
2026-09-27 pcb(silk): add user txt
    [s6tm-detect-cb-2.kicad_pcb]
2026-09-27 generate production files
    [bom.csv, designators.csv, positions.csv, s6tm-detect-cb-2.kicad_pcb, s6tm-detect-cb-2.kicad_sch]
